ultrazohm/uz_a_ads5272/Project Outputs for UltraZohm_Analog_ADS5272/BOM/BOM_UltraZohm_Analog_ADS5272_3v01.xlsx

Name | Designator | Value | Description | Package | Tolerance | Voltage | Dielectricum | Footprint | Manufacturer 1 | Manufacturer Part Number 1 | Supplier 1 | Supplier Part Number 1 | Supplier Unit Price 1 | Quantity | Supplier Subtotal 1
Ferrite bead | BS1, BS2, BS3, BS4 |  | 6A | 1206 |  |  |  | RES_1206 | Wurth Electronics | 742792121 | Digi-Key | 732-4654-1-ND | 0.24 | 4 | 0.96
100nF | C1A, C1B, C2A, C2B, C4, C10, C13, C15, C16, C17, C18, C19, C20, C21, C22, C23, C24, C25, C28, C29, C30, C31, C32, C33, C34, C35A, C35B, C36A, C36B, C37A, C37B, C38A, C38B, C39A, C39B, C40, C44, C46, C49A, C49B, C53, C55, C56, C57, C58, C59, C68A, C68B, C68C, C68D, C68E, C68F, C68G, C68H, C69A, C69B, C69C, C69D, C69E, C69F, C69G, C69H, C70A, C70B, C70C, C70D, C70E, C70F, C70G, C70H, C73, C74, C75, C76, C77, C78, C85A, C85B, C85C, C85D, C85E, C85F, C85G, C85H, C88, C89, C90, C91 | 100nF | Capacitor | 0603 | 10% | 35V | X7R | CAP_0603 | KEMET | C0603C104M5RACTU | Digi-Key | 399-7845-1-ND | 0.0158 | 88 | 1.58
1µF | C3, C14, C63, C71, C72 | 1µF | Capacitor Ceramic | 0603 | 10% | 50 V | X7R | CAP_0603 | KEMET | C0603C105K3RACTU | Digi-Key | 399-7376-1-ND | 0.28 | 5 | 1.4
2.2µF | C26, C27 | 2.2µF | Capacitor | 0603 | 10% | 10V | X7R | CAP_0603 | KEMET | C0603C225K8RACTU | Digi-Key | 399-11681-1-ND | 0.28 | 2 | 0.56
200pF | C41A, C41B, C42A, C42B, C45A, C45B, C47A, C47B, C50A, C50B, C51A, C51B, C54A, C54B, C64A, C64B | 200pF | Capacitor | 0603 | 5% | 16V | CG0 | CAP_0603 | Walsin Technologies | 0603N201J500CT | Digi-Key | 1292-1499-1-ND | 0.062 | 16 | 0.992
100pF | C43A, C43B, C48A, C48B, C52A, C52B, C65A, C65B | 100pF | Capacitor | 0603 | 5% | 16V | CG0 | CAP_0603 | Wurth Electronics | 885012006023 | Digi-Key | 732-7766-1-ND | 0.025 | 8 | 0.25
68µF | C60, C61 | 68µF | WCAP-ATG8 THT Aluminum Electrolytic Capacitors, D6.3mm x L11mm, 68uF, +/-20%, 35VDC |  | +/-20% | 35V |  | WCAP-ATG8_6.3x11 | Wurth Electronics | 860010573006 | Digi-Key | 732-8736-1-ND | 0.13 | 2 | 0.26
10µF | C62, C66, C67 | 10µF | Capacitor | 1206 | 10% | 35 V | X7R | RES_1206 | Murata | GRM319R6YA106KA12D | Digi-Key | 490-9964-1-ND | 0.34 | 3 | 1.02
470pF | C79 | 470pF | Capacitor | 1206 | 10% | 1000V | X7R | RES_1206 | Wurth Electronics | 885342208017 | Digi-Key | 732-12097-1-ND | 0.17 | 1 | 0.17
100nF | C81A, C81B, C82A, C82B, C83A, C83B, C84A, C84B | 100nF | Capacitor | 1206 | 10% | 25V | X7R | RES_1206 | KEMET | C1206C104K3RACTU | Digi-Key | 399-8140-1-ND | 0.086 | 8 | 0.86
Blue, 3.2V | D1 |  | WL-SMCW SMT Mono-color Chip LED Waterclear, size 0603, Blue, 3.2V, 140deg | 0603 |  |  |  | WL-SMCW_0603_H=0.7mm | Wurth Electronics | 150060BS75000 | Digi-Key | 732-4966-1-ND | 0.16 | 1 | 0.16
Bright Green, 2V | D2 |  | WL-SMCW SMT Mono-color Chip LED Waterclear, size 0603, Bright Green, 2V, 140deg | 0603 |  |  |  | WL-SMCW_0603_H=0.7mm | Wurth Electronics | 150060VS75000 | Digi-Key | 732-4980-1-ND | 0.14 | 1 | 0.14
Super Red, 1.9V | D3 |  | WL-SMCW SMT Mono-color Chip LED Waterclear, size 0603, Super Red, 1.9V, 140deg | 0603 |  |  |  | WL-SMCW_0603_H=0.7mm | Wurth Electronics | 150060SS75000 | Digi-Key | 732-4979-1-ND | 0.14 | 1 | 0.14
Yellow, 2V | D4, D5, D6, D7, D8, D9, D10, D11 |  | WL-SMCW SMT Mono-color Chip LED Waterclear, size 0603, Yellow, 2V, 140deg | 0603 |  |  |  | WL-SMCW_0603_H=0.7mm | Wurth Electronics | 150060YS75000 | Digi-Key | 732-4981-1-ND | 0.14 | 8 | 1.12
RJHSE-5380-02 | J1 |  | Modular Jack WR-MJ, Tab Up, Shielded, Dual Port, Righ Angle, THT, 8P8C |  |  |  |  | RJHSE-5380-02 | Amphenol ICC | RJHSE-5380-02 | Digi-Key | RJHSE-5380-02-ND | 2.78 | 1 | 2.78
 | JTAG CPLD |  | Header, 5-Pin, Dual row, Vertical |  |  |  |  | HEADER_JTAG - MAXII Horizontal | Wurth Electronics | 61201021721 | Digi-Key | 732-2098-ND | 0.59 | 1 | 0.59
15uH | L2 | 15uH | SMT power Inductor, 15uH, 40m DRC |  |  |  |  | SMT_inductor_1050_Performance |  |  | Digikey | 811-3837-1-ND |  | 1
X95840_ | POT1, POT2 |  | Digital Trimmer |  |  |  |  | TSSO6X6-G20/D6.6 | Intersil | X95840WV20IZ-2.7 | Digi-Key | X95840WV20IZ-2.7-ND | 8.38 | 2 | 16.76
2.2k | R1, R2, R21, R22 | 2.2k |  | 0603 | 1% |  |  | RES_0603 | Yageo | RC0603FR-072K2L | Digi-Key | 311-2.20KHRCT-ND | 0.024 | 4 | 0.24
220 | R3, R20 | 220 |  | 0603 | 1% |  |  | RES_0603 | Yageo | RC0603JR-07220RL | Digi-Key | 311-220GRCT-ND | 0.1 | 2 | 0.2
1k | R4, R5, R6, R7, R8, R9, R10, R11, R53 | 1k |  | 0603 | 1% |  |  | RES_0603 | Yageo | RC0603FR-071KL | Digi-Key | 311-1.00KHRCT-ND | 0.024 | 9 | 0.24
10k | R12, R56, R73, R74, R75, R80, R81, R82, R83 | 10k |  | 0603 | 1% |  |  | RES_0603 | Yageo | RT0603DRD0710KL | Digi-Key | 311-10KDCT-ND | 0.144 | 9 | 1.44
0 | R14, R41, R48 | 0 |  | 0603 | 1% |  |  | RES_0603 | Yageo | RC0603JR-070RL | Digi-Key | 311-0.0GRCT-ND | 0.017 | 3 | 0.17
4.7k | R16 | 4.7k |  | 0603 | 1% |  |  | RES_0603 | Vishay | CRCW04025R10JNEDC | Digi-Key | 311-4.70KHRCT-ND | 0.1 | 1 | 0.1
2 | R17, R18 | 2 |  | 0603 | 1% |  |  | RES_0603 | Yageo | RC0603FR-072RL | Digi-Key | 311-2.00HRCT-ND | 0.1 | 2 | 0.2
56k | R19 | 56k |  | 0603 | 1% |  |  | RES_0603 | Yageo | RT0603DRD0756KL | Digi-Key | 311-56KDCT-ND | 0.17 | 1 | 0.17
10k | R23A, R23B, R24A, R24B, R26A, R26B, R26C, R26D, R26E, R26F, R26G, R26H | 10k | Chip Resistor Array 0606, 4xR |  |  |  |  | CAC-80P320X160-8N | Vishay Beyschlag | ACASA1002S1002P100 | Digi-Key | 749-1023-1-ND | 0.603 | 12 | 7.24
100k | R25A, R25B, R25C, R25D, R25E, R25F, R25G, R25H | 100k | Chip Resistor Array 0606, 4xR |  |  |  |  | CAC-80P320X160-8N | Vishay Beyschlag | ACASA1003S1003P1AT | Digi-Key | 749-1032-1-ND | 0.77 | 8 | 6.16
2.2M | R27 | 2.2M |  | 0603 | 1% |  |  | RES_0603 | Yageo | RC0603FR-072M2L | Digi-Key | YAG3329CT-ND | 0.1 | 1 | 0.1
1M | R28 | 1M | Resistor | 1206 | 1% |  |  | RES_1206 | Vishay Dale | CRCW12101M00JNEA | Digi-Key | 541-1.0MVCT-ND | 0.22 | 1 | 0.22
48.7 | R31A, R31B, R34A, R34B, R37A, R37B, R40A, R40B, R43A, R43B, R46A, R46B, R49A, R49B, R52A, R52B | 48.7 |  | 0603 | 0.1% |  |  | RES_0603 | Panasonic | ERA-3AEB48R7V | Digi-Key | P48.7DBCT-ND | 0.26 | 16 | 4.16
39.2k | R32A, R32B, R33A, R33B, R38A, R38B, R39A, R39B, R44A, R44B, R45A, R45B, R50A, R50B, R51A, R51B | 39.2k |  | 0603 | 0.1% |  |  | RES_0603 | Panasonic | ERA-3AEB3922V | Digi-Key | P39.2KDBCT-ND | 0.26 | 16 | 4.16
100k | R35 | 100k |  | 0603 | 1% |  |  | RES_0603 | Yageo | RC0603FR-07100KL | Digi-Key | 311-100KHRCT-ND | 0.1 | 1 | 0.1
38.3k | R36 | 38.3k |  | 0603 | 1% |  |  | RES_0603 | Yageo | RC0603FR-0738K3L | Digi-Key | 311-38.3KHRCT-ND | 0.1 | 1 | 0.1
82 | R57A, R57B, R58A, R58B, R62A, R62B, R63A, R63B | 82 | Limiter Resistor | 1206 | 0.1% |  |  | RES_1206 | Panasonic | ERA8AEB820V | Digi-Key | P82BCCT-ND | 0.41 | 8 | 4.1
20k | R89 | 20k |  | 0603 | 1% |  |  | RES_0603 | Yageo | RC0603FR-07330RL | Digi-Key | 311-330HRCT-ND | 0.1 | 1 | 0.1
VREF 3.3V/1.65V | REF1, REF2 |  |  |  |  |  |  | SOT-23-5 | Texas Instruments | REF2033AIDDCT | Digi-Key | 296-40487-1-ND | 3.98 | 2 | 7.96
THS4524 | U1A, U1B |  | Quad Channel fully differential Amplilfier | TSSOP-38 |  |  |  | THS4524 Footprint | Texas Instruments | THS4524IDBTR | Digi-Key | 296-24315-1-ND | 7.33 | 2 | 14.66
OPA4344 | U4A, U4B, U4C, U4D, U4E, U4F, U4G, U4H |  | opamp rai to rail 1mV |  |  |  |  | TSSO5X6-G14/X.3 | Texas Instruments | OPA4344EA/250 | Digi-Key | OPA4344EACT-ND | 3.83 | 8 | 30.64
ADS5272 | U5 |  |  |  |  |  |  | TSQFP50P1400X1400_HS-80M | Texas Instruments | ADS5272IPFP | Digi-Key | 296-18605-ND | 124.86 | 1 | 124.86
MC74VHC1G00DFT1 | U6A, U6B, U6C, U6D, U6E, U6F, U6G, U6H |  | 2-Input NAND Gate |  |  |  |  | SOT-353 | ON Semiconductor | MC74VHC1G00DFT1G | Digi-Key | MC74VHC1G00DFT1GOSCT-ND | 0.32 | 8 | 2.56
uMAX962 | U7A, U7B, U7C, U7D, U7E, U7F, U7G, U7H |  | IC COMPARATOR BTR 8-UMAX |  |  |  |  | 8-MSOP | Maxim | MAX962EUA+ | Digi-Key | MAX962EUA+-ND | 7 | 8 | 56
TL071 | U11 |  | IC OPAMP JFET 3MHZ 8SOIC |  |  |  |  | SOIC8_N | Texas Instruments | TL071CDR | Digi-Key | 296-14994-1-ND | 0.53 | 1 | 0.53
5M570ZT100C5N | U12 |  | MAX V CPLD 440MC 9NS 100TQFP |  |  |  |  | TQFP100_N | Intel Altera | 5M570ZT100C5N | Digikey | 544-2839-ND |  | 1
Buck Converter | U16 |  | 3.8V to 36V, 2A synchronous step-down converter |  |  |  |  | SOIC127P600X170_HS-9N | Texas Instruments | LMR33620ADDA | Digi-Key | 296-48841-ND | 2.43 | 1 | 2.43
1.8V LDO | U18 |  | 1A Positive 1.8V Fixed-Voltage Low-Dropout Regulator |  |  |  |  | SOT230P700X170-4N | Texas Instruments | TLV1117LV18DCYT | Mouser | 595-TLV1117LV18DCYT | 0.56 | 1 | 0.56
20MHz | X1 | 20MHz | Oscilador 20MHz |  |  |  |  | CRYSTALOSC | CTS | CB3LV-3C-20M000000 | Digi-Key | 110-CB3LV-3C-20M000000CT-ND | 1.41 | 1 | 1.41
