ultrazohm/uz_a_ads5272/Project Outputs for UltraZohm_Analog_ADS5272/ASM_UltraZohm_Analog_ADS5272_3v01.PDF

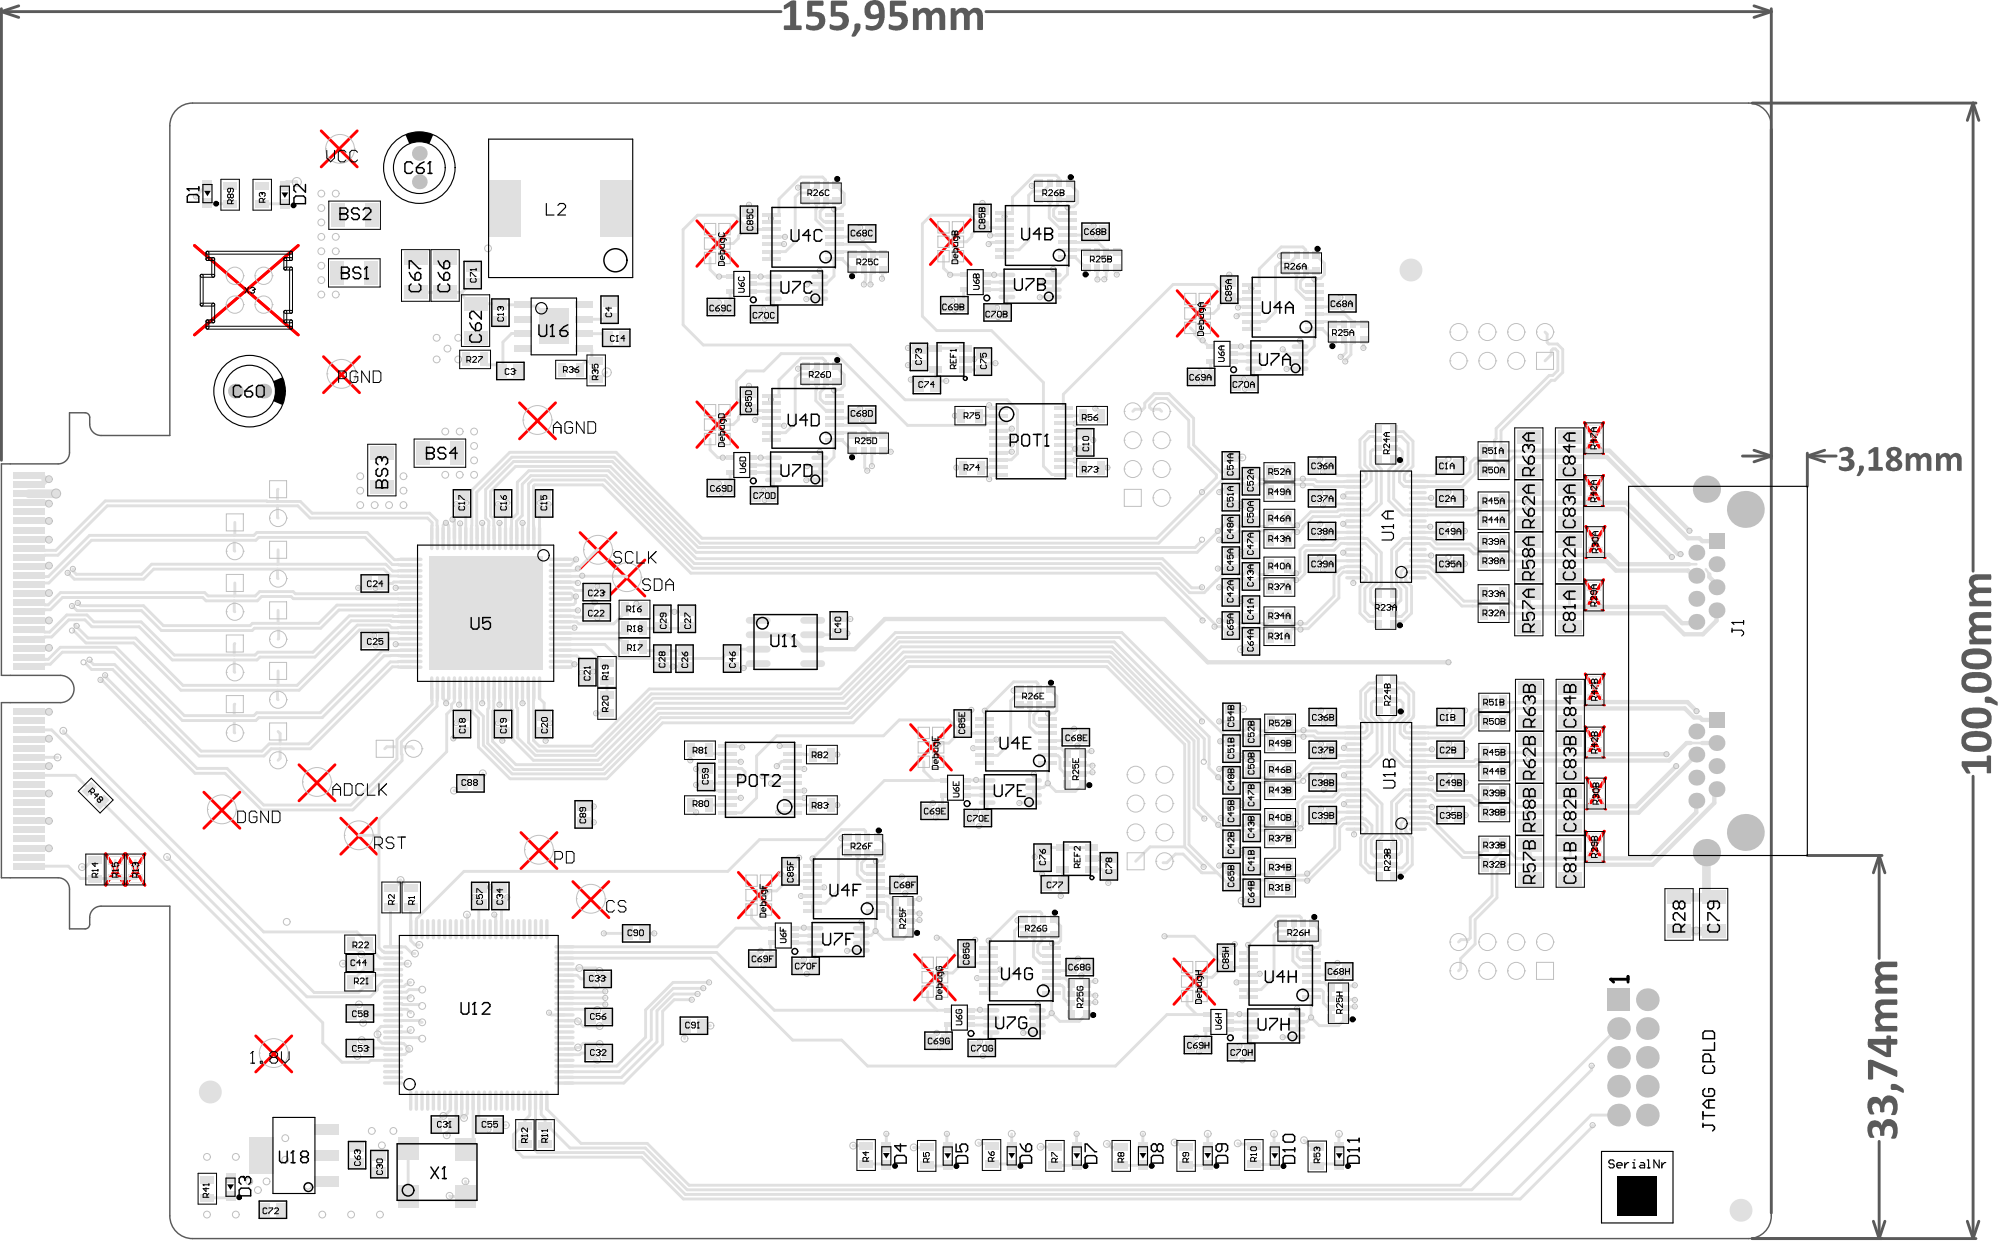
[picture p1: page 1]

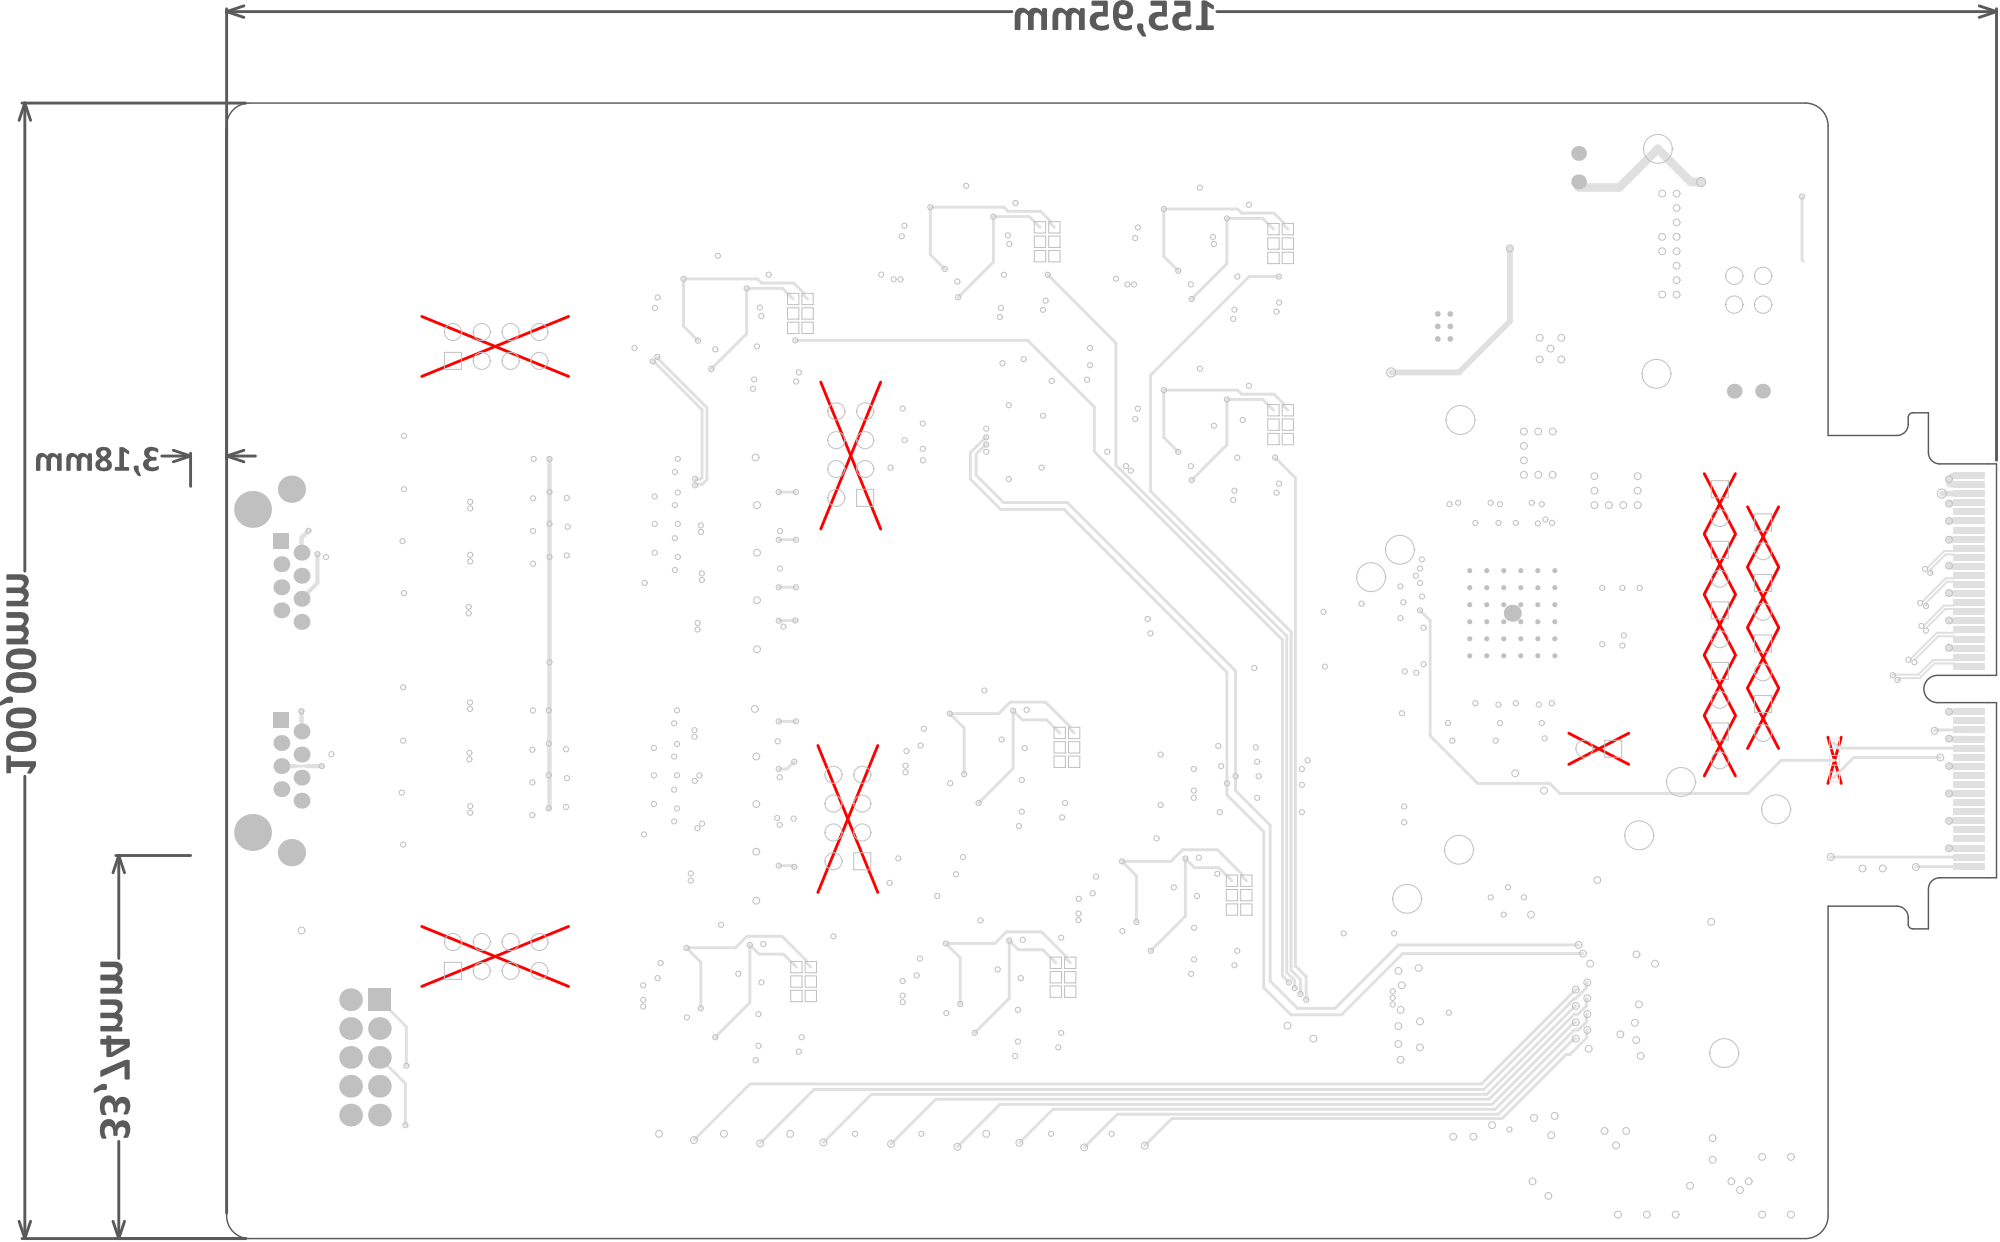
[picture p2: page 2]
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
