ultrazohm/uz_a_ads5272/Project Outputs for UltraZohm_Analog_ADS5272/3D_View_Top.PDF

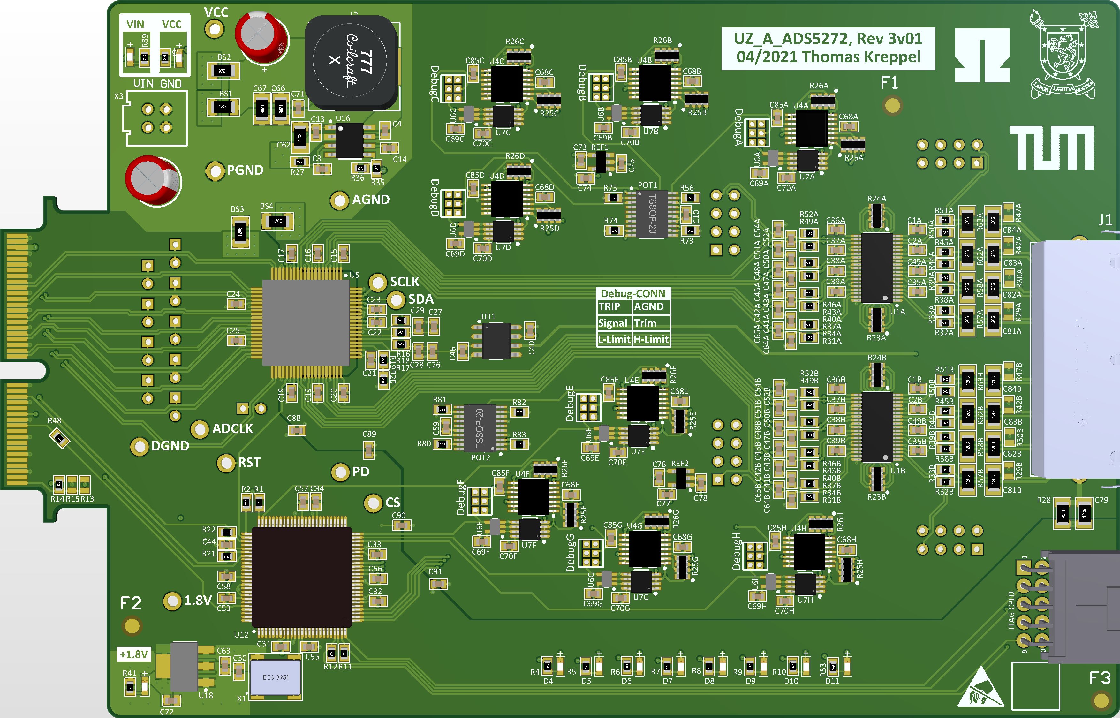
[picture p3: page 1]
