ultrazohm/uz_a_ads5272/Diff to Diff simulacion/Diferencial to Diferencial.asc

R1: res; 10k
R2: res; 39k
R5: res; 10k
R8: res; 39k
U1: LT1994
V1: voltage; 1.5
V2: voltage; 3.3
V3: voltage; 1.45
V4: voltage; -5
V5: voltage; 5
V6: voltage; SINE(0 4 1000); AC 1 0
V8: voltage; 5
V9: voltage; -5
Named nets: 0, +Vcc, -Vcc, +5V, Vref_Ext, +5V_Ext, -5V_Ext, VCM
.tran 0 0.005 0 1e-5
