ultrazohm/uz_a_ads5272/(list of files, drawings)

Other design files:
ADC.SchDoc
Altium Library/Componentes_SOC.SchLib
Analog Inputs.SchDoc
CPLD.SchDoc
Digital Trimmers.SchDoc
Interface Connector.SchDoc
Led.SchDoc
Opamps.SchDoc
Power supplies.SchDoc
Principal.SchDoc
Trip Detector.SchDoc
UltraZohm_Analog_ADS5272.PrjPcb
