ultrazohm/uz_a_ads5272/(commit log)

2020-03-20 First Initialization
    [ADC.SchDoc, Analog Inputs.SchDoc, BOM UltraZohm Analog Fast ADC 1v01 ADS5272 3U.xls, Buffer_Out.SchDoc, Conector Interfaz.SchDoc, Digital Trimmers.SchDoc, Entradas Analogicas.SchDoc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]
2020-04-20 Add libs
    [ADC.SchDoc, Componentes_SOC.SchLib]
2020-04-24 Reworked Schematics
    [ADC.SchDoc, Analog Inputs.SchDoc, Coilcraft-MSS1210.STEP, Componentes_SOC.SchLib, Digital Trimmers.SchDoc, Interface Connector.SchDoc, Led.SchDoc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]
2020-04-24 Remove History, Previews, Logs from Repository
    [Principal.SchDoc]
2020-04-24 Component placement
    [ADC.SchDoc, Digital Trimmers.SchDoc, Led.SchDoc, Opamps.SchDoc, Principal.SchDoc, Trip Detector.SchDoc]
2020-04-25 Finished Layout
    [UltraZohm Analog Fast ADC 1v01 ADS5272 3U.PrjPcb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]
2020-04-29 Implemented changes as discussed on 27.04
    [ADC.SchDoc, Analog Inputs.SchDoc, Componentes_SOC.SchLib, Digital Trimmers.SchDoc, Interface Connector.SchDoc, Led.SchDoc, Opamps.SchDoc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]
2020-04-29 Added RC delay to enable
    [Power supplies.SchDoc]
2020-05-04 Changed FB trace, ADC footprint, 1.8V LED, schematic template
    [ADC.SchDoc, Analog Inputs.SchDoc, Digital Trimmers.SchDoc, Interface Connector.SchDoc, Led.SchDoc, Opamps.SchDoc, Power supplies.SchDoc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]
2020-05-05 Selected RC enable
    [Power supplies.SchDoc]
2020-05-07 Updated FB resistors
    [Power supplies.SchDoc, User Library-testpoint.STEP]
2020-06-02 Change file names
    [BOM UltraZohm Analog Fast ADC 1v01 ADS5272 3U.xls, UltraZohm Analog Fast ADC 1v01 ADS5272 3U.PrjPcb, UltraZohm_Analog_ADS5272.PrjPcb]
2020-06-02 Update bom Update output job. Added step file
    [ADC.SchDoc, Analog Inputs.SchDoc, Digital Trimmers.SchDoc, Interface Connector.SchDoc, Led.SchDoc, Opamps.SchDoc, Power supplies.SchDoc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]
2020-06-04 Check and update BOM, Update output job, delete old files, create interactive BOM
    [Bill of Materials-UltraZohm_Analog_ADS5272.xlsx, UltraZohm_Analog_ADS5272.xlsx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]
2020-06-06 Commit to pull
    [UltraZohm Analog Fast ADC 1v01 ADS5272 3U.PrjPcb]
2020-06-06 Generated Outputs
    [Componentes_SOC.SchLib, Principal.SchDoc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]
2020-06-07 Added more testpoints
    [ADC.SchDoc, Componentes_SOC.SchLib, Principal.SchDoc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]
2020-06-08 Update Name Lable
    [UltraZohm_Analog_ADS5272.GBL, UltraZohm_Analog_ADS5272.GBO, UltraZohm_Analog_ADS5272.GBP, UltraZohm_Analog_ADS5272.GBS, UltraZohm_Analog_ADS5272.GKO, UltraZohm_Analog_ADS5272.GM1, UltraZohm_Analog_ADS5272.GTL, UltraZohm_Analog_ADS5272.GTO]
2020-06-10 More files
    [Analog Inputs.SchDoc, BOM_UltraZohm_Analog_ADS5272_1v01.xlsx, Bill of Materials-UltraZohm_Analog_ADS5272.xlsx, Led.SchDoc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]
2020-06-16 Generate final gerber for ordering
    [ADC.SchDoc, BOM_UltraZohm_Analog_ADS5272_1v01.xlsx, Digital Trimmers.SchDoc, Interface Connector.SchDoc, Led.SchDoc, Opamps.SchDoc, Power supplies.SchDoc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]
2020-07-19 Add jumper for negative input
    [Opamps.SchDoc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]
2020-09-06 Layout V2
    [Digital Trimmers.SchDoc, UltraZohm_Analog_ADS5272.PrjPcb]
2020-09-07 Revision Comments David
    [Led.SchDoc, UltraZohm_Analog_ADS5272.PrjPcb]
2020-09-08 Generate Gerber V2
    [UltraZohm_Analog_ADS5272.GBL, UltraZohm_Analog_ADS5272.GBO, UltraZohm_Analog_ADS5272.GBP, UltraZohm_Analog_ADS5272.GBS, UltraZohm_Analog_ADS5272.GM1, UltraZohm_Analog_ADS5272.GTL, UltraZohm_Analog_ADS5272.GTP, UltraZohm_Analog_ADS5272.GTS]
2020-11-02 Add CPLD reset and remove lvl shift from ADCLK
    [Interface Connector.SchDoc, Principal.SchDoc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]
2021-03-20 Prepare V3 for production
    [ADC.SchDoc, Analog Inputs.SchDoc, BOM_UltraZohm_Analog_ADS5272_1v01.xlsx, BOM_UltraZohm_Analog_ADS5272_3v01.xlsx, Interface Connector.SchDoc, Led.SchDoc, Power supplies.SchDoc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]
2021-03-31 add rounded corners
    [Principal.SchDoc, UltraZohm_Analog_ADS5272.PrjPcb]
2021-04-07 Changes according to David review
    [ADC.SchDoc, Analog Inputs.SchDoc, BOM_UltraZohm_Analog_ADS5272_3v01.xlsx, Componentes_SOC.SchLib, Digital Trimmers.SchDoc, Interface Connector.SchDoc, Led.SchDoc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]
2021-04-08 review Eyke
    [ADC.SchDoc, Analog Inputs.SchDoc, BOM_UltraZohm_Analog_ADS5272_3v01.xlsx, Digital Trimmers.SchDoc, Interface Connector.SchDoc, Led.SchDoc, Opamps.SchDoc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]
2021-04-14 update bom non-stocked components change repo name regenerate fabrications outputs
    [BOM_UltraZohm_Analog_ADS5272_3v01.xlsx, Buffer_Out.SchDoc, Coilcraft-MSS1210.STEP, Conector Interfaz.SchDoc, Entradas Analogicas.SchDoc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]
2021-04-14 Cross-out Through-hole components for assembly
    [UltraZohm_Analog_ADS5272.PrjPcb]
2021-04-16 Regenerate Fabrication outputs for SMD assembly variant.
    [BOM_UltraZohm_Analog_ADS5272_3v01.xlsx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]
2021-04-21 Run DRC and modify Pick and Place file
    [UltraZohm_Analog_ADS5272.PrjPcb]
2021-04-21 Updated value 15uH instead 15mH in power supply. Added Through hole components in SMD_assembly Regenerate fabrication outputs
    [BOM_UltraZohm_Analog_ADS5272_3v01.xlsx, Power supplies.SchDoc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]
2021-04-27 added orientation markings in ASM
    [UltraZohm_Analog_ADS5272.PrjPcb]
2021-04-27 added polarity marking for LED on ASM, fixed minor issues on silk layer
    [UltraZohm_Analog_ADS5272.GBL, UltraZohm_Analog_ADS5272.GBO, UltraZohm_Analog_ADS5272.GBP, UltraZohm_Analog_ADS5272.GBS, UltraZohm_Analog_ADS5272.GM1, UltraZohm_Analog_ADS5272.GTL, UltraZohm_Analog_ADS5272.GTP, UltraZohm_Analog_ADS5272.GTS]
2021-05-21 added drill file
2021-05-21 Zipped the new gerber
